richfelker/m45/BOM.md

## Bill of Materials - DRAFT

This document is a work in progress and is based on the current state
of the M45 public release. It does not match the earlier as-is STL
files. It may still contain known or unknown omissions. In particular,
the electronics/wiring is not covered, and general-purpose fastners
have not been counted.

This version of the BOM still uses the original 550 mm vertical
extrusion length. A future version may switch to 600 mm which will
require +100 mm adjustments to belt lengths and +50 mm adjustments to
CPAP hose lengths.

### Frame

- 550 mm 2040 T slot extrusions, ends M5-tapped (3)
- 250 mm 2040 T slot extrusions (6)

### Motion system

- 450 mm MGN12C rails (3)
- GT2 belts, 6mm (3 pieces, 1100 mm each)
- 16T GT2 pulleys for 6mm belt (6)
- 20T GT2 toothed idler for 6mm belt (3)
- 42-34 0.8A NEMA17 stepper motors (6)
- 695ZZ (5x13x4) bearings (3)
- MF148ZZ (8x14x4) flanged bearings (3)
- Optical endstops (3) ("RAMPS 1.4" module, 33.12x10.13 mm board, 19 mm M3 hole spacing)
- SeeMeCNC aluminum delta joint barbells (6, sold as a set)
- Extension springs - 0.8 mm wire diameter, 6 mm OD, 25 mm length (6)
- 246 mm carbon fiber tubes, 6 mm OD, 4 mm ID (6)

### Effector

- Delta 5V 2510 fan (1)
- VolcoMosq hotend (1)

### Part Cooling

- WS9290 CPAP blower with controller board (1)
- 19mm ID CPAP hose (1)
- 15mm ID CPAP hose (2, 500 mm each)

### Bed

- Borosilicate glass bed, 250 mm diameter, 4 mm thickness (1)
- Round kapton heater, 24v, 240-250 mm diameter (1)
- Adhesive magnetic sheet and spring steel plate, 250 mm diameter (1)

### General fastners (copious quantities)

- 8mm M3 socket head screws
- 8mm M5 socket head screws
- 10mm M5 socket head screws
- M2.5 nuts
- M3 nuts
- M3 T nuts
- M5 T nuts
- M5 washers

### Special-purpose fastners

- 6mm M3 socket head screws (motors) (15)
- 6mm M3 button head screws (carriages to blocks) (12)
- 10mm M3 button head screws (bed mounting) (3)
- 14mm M3 screws (effector barbells) (6)
- 20mm M3 socket head screws (lower motor mounts) (9)
- 6mm M2.5 button head screws (VolcoMosq to effector plate) (2)
- 12mm M2.5 button head screws (carriage belt coupling) (21)
- 16mm M2.5 button head screws (hotend fan and frame) (4)

### Extruder

- Semitruck OG or Prime, or your choice of bowden extruder (1)

### Electronics and wiring

- Not yet documented
