richfelker/m45/(commit log)

2025-04-21 initial versions of motion system components
    these are introduced as-is from the 2024 double shear 6mm gt3 build of
    the actual printer. they have known problems working with unmodified
    pulleys which will be addressed in subsequent commits. they are
    significantly different from the original 9mm gt2 versions without
    double shear support; while those files still exist in other places,
    no detailed version history was kept for the process of adding double
    shear, and reconstructing it does not seem like a productive use of
    time.
    [belt_cover.scad, carriage.scad, motor_mount_lower.scad, motor_mount_upper.scad, tension_tool.scad]
2025-04-21 trim down top motor mount base under motor
    this serves no structural purpose, but partly blocks the hole in the
    upper vertex, making it harder to run wiring, and depending on motor
    size, interferes with the motor cable socket, making it impossible to
    hide the wires under the motor.
    [motor_mount_upper.scad]
2025-04-21 indent upper motor mount source to be legible
    [motor_mount_upper.scad]
2025-04-21 remove obsolete dead code from upper motor mount
    [motor_mount_upper.scad]
2025-04-21 factor belt path mockup from upper motor mount, make it accurate to gt2
    [belt_path.scad, motor_mount_upper.scad]
2025-04-21 fix upper motor mount pulley alignment offset
    the magic number offset of 8.8 mm was close enough to the correct
    value, but the screw holes to mount to the top of the column were
    visibly off from the holes in the 2040 end, wrongly using an offset of
    3 mm instead of the difference between the pulley center offset and
    the T slot center offset (roughly 1.3 mm). this produced a belt path
    that was not entirely vertical. but sloped inward towards the center
    of the printer at the top.
    [motor_mount_upper.scad]
2025-04-21 fix parametrization errors in upper motor mount
    motor_offset parameter did not work right.
    [motor_mount_upper.scad]
2025-04-21 make upper motor pulley mockup accurate to full size pulley
    this puts it in interference with the double shear bearing assembly.
    [motor_mount_upper.scad]
2025-04-21 fix upper motor mount pulley spacing so unmodified pulley fits
    this change keeps the inside of the pulley flange nominally 4.5 mm
    from the 2040 extrusion, but moves the motor back 0.7 mm and moves the
    double shear bearing out 0.5 mm. this should still leave at least 1.3
    mm of shaft support engagement.
    [motor_mount_upper.scad]
2025-04-21 remove lots of unused, dead, likely-wrong code from lower motor mount
    [motor_mount_lower.scad]
2025-04-21 use shared belt path mockup for lower motor mount
    [motor_mount_lower.scad]
2025-04-22 move lower motor out 0.5 mm to fix unmodified pulley fit
    this is not actually quite sufficient, but will be once the conversion
    to different bearing setup is done. committed as its own change to
    make the changes easier to follow.
    [motor_mount_lower.scad]
2025-04-22 convert lower motor mount for bearings that replace pulley flange
    there is no good way to get the belt as close as desired to the 2040
    tower with both a sufficient double shear support bearing and the 1.5
    mm flange on the pulley. the current build is using a 5x10x3 bearing,
    which is undersized to begin with, and only works with a shaved-down
    pulley or a longer motor shaft.
    instead, take off the pulley flange to get 1.5 mm of engagement in a
    bearing with 8 mm ID. a flanged bearing, mf148, is used so that we can
    get the bearing as close as possible to the 2040 without it scraping.
    otherwise, the plastic would need to provide the spacing, which would
    require a separate insert part to get the r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
    [motor_mount_lower.scad]
2025-04-22 bring shared belt path mockup into carriage
    [carriage.scad]
2025-04-22 fix belt linearity at carriage attachment
    the old value 3.15 was probably either guessed, measured poorly, or
    wrongly figured from the back surface of the belt rather than the
    pitch line. update it to match the actual pitch line from the pulleys.
    this corrects a linearity error of 0.5 mm.
    this may still need further tuning to compensate for the fact that the
    belt where it enters the carriage is mated with its own opposing teeth
    rather than a pulley, which will not necessarily respect the same
    pitch line.
    as a separate issue, it currently does not match the belt mockup,
    because the mockup is based on gt2 dimensions, not the thicker gt3
    belt the carriage is currently configured for. however,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
    [carriage.scad]
2025-04-22 fix carriage belt attachment to account for belt PLD
    also move belt parameters to file scope.
    with this change, bt=1.38 (gt2) produces an exact match for the belt
    path mockup.
    [carriage.scad]
2025-04-22 remove dead code from carriage
    [carriage.scad]
2025-04-22 cleanup carriage, replace bogus ngon module with hexagon
    [carriage.scad]
2025-04-22 fix belt cover to match carriage alignment fixes
    [belt_cover.scad]
2025-04-23 begin making idler size/position in lower motor mount configurable
    [motor_mount_lower.scad]
2025-04-23 make lower motor mount belt/pulley mockups switchable
    [motor_mount_lower.scad]
2025-04-23 cleanup lower motor mount CSG
    apply the same idler zone cutout to both the motor plate and idler
    cover. this makes it easier to make changes here.
    [motor_mount_lower.scad]
2025-04-23 finish making idler size in lower motor mount configurable
    [motor_mount_lower.scad]
2025-04-23 switch lower motor mount to using 6 mm idler for 6 mm belt
    offsets are chosen to put flange in position to hold belt away from
    motor pulley bearing. inner surface of idler flange is 4.5 mm from
    2040 for 6 mm belt configuration, 3.8 mm for 9 mm belt.
    [motor_mount_lower.scad]
2025-04-23 put lower motor mount in a module
    at some point this should be properly parameterized, but this is the
    minimal change needed to make it usable from other files for assembly,
    clearance checking, etc.
    [motor_mount_lower.scad]
2025-04-23 add initial version of delta vertices
    [vertex.scad]
2025-04-23 remove lots of old/dead/unused code from delta vertex
    the removed code should all be stuff that was either very
    wrong/breaking to include, or replaced by better versions long ago.
    a small amount of inactive code is left where it might be informative
    or desirable to use in the future.
    [vertex.scad]
2025-04-24 begin factoring parameters out of delta vertex
    originally the vertices were constructed by CSG subtracting out a
    full, 3-tower negative of the extrusions and screws from a base block.
    this is not only inefficient, but gratuitously carried a dependence on
    the frame size parameters (which cancelled out with themselves)
    despite the vertices being intended to be frame-size-invariant parts.
    this commit factors the cancelling XY translations out of the column
    negative, but still leaves the height dependency and everything for
    the end extrusions in place.
    [vertex.scad]
2025-04-24 factor diameter parameter out of vertex end extrusion holes
    [vertex.scad]
2025-04-24 factor extrusion height parameter out of vertex holes
    [vertex.scad]
2025-04-24 finish factoring machine diameter out of vertex holes
    [vertex.scad]
2025-04-28 slightly improve double shear bearing engagement on upper motor mount
    a test print checked against motor with 18 mm shaft measured only 1.41
    mm of engagement, likely due to bearing holder/hole being sized 0.2 mm
    deeper than the mocked-up bearing. adjust so there's only 0.2 mm
    design clearance on each side of the pulley.
    [motor_mount_upper.scad]
2025-04-28 switch side of carriage belt cover to inside
    this improves printability (no bridging), allows the belt coupling
    zone and the corner connecting to it to be much thicker/stiffer, and
    sets the stage for 9 mm belt support if desired.
    [belt_cover.scad, carriage.scad]
2025-04-28 improve printability of barbell alignment ridge on carriage
    the ridge cut near the screw holes/chamfers produced some tiny path
    components in some layers, which could print poorly and interfere with
    clean alignment. add larger cutouts here to avoid the problem.
    [carriage.scad]
2025-04-28 switch carriage belt coupling slot from gt3 to gt2 size
    gt3 looks to be disadvantageous; either 6mm or 9mm gt2 is likely to be
    the long-term recommended belt choice.
    [carriage.scad]
2025-04-28 remove gratuitous block clearance to rail block
    all this did was add a slight error to belt alignment and interference
    geometry on the back face of the carriage (at the flag) which could
    lead to inaccuracies in mounting.
    [carriage.scad]
2025-04-29 remove unused parameters from delta vertex
    these are all frame assembly parameters that were factored out, not
    parameters of the vertex.
    [vertex.scad]
2025-04-29 move vertex extrusion slot clearances to (global) parameters
    [vertex.scad]
2025-04-29 remove gratuitous render() in vertex scad
    [vertex.scad]
2025-05-06 fix carriage interference with ball cups at far-to-side arm angles
    this interference was overlooked when the carriage was made thicker to
    flip the side the belt cover goes on; clearances had not been updated
    for the larger ball cups.
    the base radius of 8.5 is to allow 0.5 mm clearance to a nominal 16 mm
    outer cup diameter. an offset of 1 mm is added to radius and center
    point to keep the overhang cleanly printable in the print orientation.
    [carriage.scad]
2025-06-24 add files needed for effector skirt (cooling attachment)
    [lower_plate.scad, plate.scad, skirt.scad]
2025-06-24 refactor/simplify delta vertex stuff
    these changes were sitting uncommitted since the previous work, and
    mostly wrap up the changes decoupling the vertex from frame cad and
    de-parameterizing it.
    [vertex.scad]
2025-06-24 make front effector skirt area cooling vents optional
    also fix logic for offset to the holes.
    [skirt.scad]
2025-06-24 adjust effector skirt area cooling vents for non-open front
    [skirt.scad]
2025-09-22 add full printer assembly file (work in progress)
    [m45.scad]
2025-09-22 add motor mounts to printer assembly
    [m45.scad]
2025-09-22 add carriage and barbell to assembly
    [m45.scad]
2025-09-22 add motor mockups to assembly
    [m45.scad]
2025-09-23 fix top motor position in assembly
    [m45.scad]
2025-09-23 conditionalize mock pulley etc. in upper motor mount
    without this, the mocks propagate to the assembly and colorization
    overrides the styling for %.
    [motor_mount_upper.scad]
2025-09-30 add outdated and disorganized draft BOM
    as a basis for history of changes from this point.
2025-09-30 update belt and pulley types in BOM
2025-09-30 update lower motor mount bearing in BOM
    to match changes in commit 8189f8a43a.
2025-09-30 major updates to BOM for public release
    - text on status of the BOM is updated.
    - incomplete broken-down faster counts per area have been removed.
    - headings are fixed.
    - parts are better organized.
    - part cooling, hotend, and bed parts are added.
    - specialized (non-bulk) fastners are added.
2025-10-08 add barbell mockup
    this is not actually a printed/printable part, but used in the full
    printer assembly and (not yet present) effector assembly.
    [barbell.scad]
2025-10-08 clean up and remove cruft from carriage source
    removed tabs were from when open side of belt coupling printed down
    against the bed and were for printability, snipping after printing.
    barbell mockup is fixed not to depend on an stl file that's not
    present but instead to use the source.
    [carriage.scad]
2025-10-08 avoid default-initializing one parameter with another in carriage scad
    this does not seem to be supported by older openscad versions and
    the default-initialization isn't actually used here anyway.
    [carriage.scad]
2025-10-09 add parameter to select upper/lower vertex position
    this is needed to be able to generate both variants via customizer or
    command line without editing source.
    [vertex.scad]
2025-10-09 add vertex option to orient for printing
    this was always intended but was lost somewhere in the clean-up for
    publication. for now, just do the rotations. i'd like to position them
    at z=0, but haven't bothered to do the math for that, and it really
    doesn't matter for normal printing workflows.
    [vertex.scad]
2025-10-10 add basic guide for printed parts
    this is quickly thrown together but better than nothing.
2025-10-12 add ballcup-specific printing instructions
2025-10-12 correct wrong length for carriage belt coupling screws in the BOM
